PopUpPlayground/room-service/README.md

## Room Service

Code and hardware designs for Room Service, a game by Pop Up Playground.

- [YouTube Trailer](https://www.youtube.com/watch?v=t-5_sdyJ_b8)
- [Bookings](http://elsewhererooms.com/bookings/)

## Building

- Install `platformio`
- Type `make`

## Targets

- `native` - Used for local tests
- `teensy32` - Compiled game, no data files.
- `roomservice` - Compiled game, room service data files.

## Where are the data files?

They're the only thing *not* in the repository. They'd be super-mega spoilers for players
of the game!
