PopUpPlayground/room-service/(threads)

Thread 1 (2016-08-17):

Keypad requirements

pjf, 2016-08-17:
Keypad specs:

- 12 key (0-9, *, #)
- Must look cool (sample attached)
- Slight preference for 7-pin (x,y) models, versus 12-pin (individual key) models. We're unlikely to use multi-touch.

---

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

pjf, 2016-08-17:
This keypad [from jaycar](http://www.jaycar.com.au/12-key-numeric-keypad/p/SP0770) is $9, and looks good to me. :)

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

KangaBounce, 2016-08-21:
Jaycar keypad looks great!

pjf, 2016-08-22:
Note: We're going to star as reset, hash as execute (coding).

pjf, 2016-09-06:
I have the Jaycar keypad working ( #14, 213365fc08fd182e1176cfbd6afdc8c4fe0e40ae). The keys are rated to 1,000,000 keypresses. Assuming a typical game has a thousand key-presses, the pad should last a thousand games.

We may still go with another keypad for stylistic issues, but paying $9 every thousand games for keypad replacement is a really nice starting point. :)

pjf, 2016-09-30:
The $9 keypad is working great.

Closed 2016-09-30.

Thread 2 (2016-08-17):

Globes

pjf, 2016-08-17:
Globes are on of the things I'm most interested in, because they're going to take a lot of our power load, and will require the bulk of our control circuitry.

Requirements:

- Looks cool
- DC power (easier control circuitry)
- No more than 17V¹
- User-serviceable if not LEDs (which last forever)

¹ Assuming we're using a nifty power driver. 12V preferred.

pjf, 2016-08-18:
After evaluating control options ( #5 ), anything that uses 5V and up to 120mA looks way more attractive as we can control using I2C doohickies.

pjf, 2016-08-18:
Update: The drivers in #5 are low-side that allow up to 17V of voltage. We're golden. :)

pjf, 2016-08-22:
We have lights! We're using:

- ZD0150 Red LEDs
- ZD0170 Green LEDs
- SL???? Red Bezels
- SL2622 Green Bezels

We need:

- [ ] The number of LEDs we need total
    - Rooms
    - Doors
    - Baddies count
    - System load

pjf, 2016-09-05:
- [ZD0150](http://www.jaycar.com.au/red-5mm-led-12mcd-round-diffused/p/ZD0150)s take up to 30mA, provide 12mCd, 5mm, diffused $0.30ea. Not sure if 12mCd is a typo; probably not because diffuse.
- [ZD0152](http://www.jaycar.com.au/red-5mm-led-1200mcd-round-clear/p/ZD0152)s take up to 30mA, provide 1200mCd, 5mm, clear, $0.85ea
- [ZD0154](http://www.jaycar.com.au/red-5mm-led-3800mcd-round-clear/p/ZD0154)s, up to 50mA (more than we can drive on single-pins), 3800mCd, clear, $1.45ea
- [ZD0156](http://www.jaycar.com.au/red-5mm-led-9600mcd-round-clear/p/ZD0156) are magic. Up to 50mA, 9600mCd, clear, $3.45ea

I'm going to try and demonstrate ZD0152s since they're going to be much more visible in a range of lighting, but being a lens-type rather than diffuse-type pokéLeds mean they might not give us the old-school look we're after.

pjf, 2016-09-05:
10mm LEDs would also work:

- [ZD0200](http://www.jaycar.com.au/red-10mm-led-8mcd-round-diffused/p/ZD0200), $0.75ea, 8mCd diffuse
- [ZD0201](http://www.jaycar.com.au/red-10mm-led-5600mcd-round-clear/p/ZD0201), $1.45ea, 50mA, 5600mCd, $1.45ea, lensed

pjf, 2016-09-21:
Globes are ordered and in. We're using ZD150s, ZD0152s, and SL2622 and SL???? bezels.

Closed 2016-09-21.

Thread 5 (2016-08-17):

Drivers for lights

pjf, 2016-08-17:
We're likely to need a boatload of shift registers or other circuitry to control the scores of lights we'll be operating.

The [74HC164](http://www.jaycar.com.au/74hc164-8-bit-serial-in-out-shift-register-ic/p/ZC4857) serial-in, parallel-out shift registers are $1.75 each, and look like they can run off a supply voltage of anywhere from 2V to 7V, so they're probably good for our needs (anticipating a 3.3V microcontroller, but maybe a 5V one).

---

Status: Have a [TLC5947](https://www.adafruit.com/product/1429) on order from AdaFruit to test with.

pjf, 2016-08-17:
Other (probably better) options:

- [STP16CP05](http://www.st.com/content/ccc/resource/technical/document/datasheet/f2/92/00/f9/dd/4a/43/22/CD00126634.pdf/files/CD00126634.pdf/jcr:content/translations/en.CD0012663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) runs up to 16 lights at 100mA, as a shift register.
- [TLC59116](http://www.ti.com/lit/ds/symlink/tlc59116.pdf) runs up to 16 lights up to 120mA @ 17V as an I2C controller. 3.3 and 5V compatible, *and* supports PWM.

TLC59116 looks like it's winning hardware wise.

pjf, 2016-08-18:
OMG, the TLC59116 is a low-side driver that lets us push up to 17V through the load. Duck yes.

pjf, 2016-08-18:
https://www.adafruit.com/product/1429 lets us control up to 30mA with 24 lines out, based on the TLC5947 chip. It's an SPI using shift register with PWM support.

Most importantly, it has nice pitch. I like the TLC59116 more, but this is something we could reasonably solder. :)

pjf, 2016-08-18:
LittleBird has the [TLC5947](https://littlebirdelectronics.com.au/products/adafruit-24-channel-12-bit-pwm-led-driver-spi-interface-tlc5947) controllers from AdaFruit, so these are currently winning despite not being I2C.

pjf, 2016-08-21:
Have ordered a TLC5947 from LittleBird to test with.

pjf, 2016-08-21:
LittleBird don't have the TLC5947 in stock. I've asked how long a wait we're looking for; we may switch drivers if it's too long.

pjf, 2016-08-21:
TronixLabs has a TLC5947; on way! :)

pjf, 2016-08-28:
After diagnosing a poorly soldered joint on the controller I was using, I was able to get the TLC5947 to work beautifully as a driver. The programming is very straightforward using the library from AdaFruit:

```C++
void loop() {

  // Turn all the lights on to full
  for (int i=0; i <= 23; i++) {
    tlc.setPWM(i, 4095);
  }
  tlc.write(); // Sends cmd to board
  digitalWrite(pwr,HIGH); // Set diagnostic LED on teensy

  delay(1000);

// Turn all the lights off again.
  for (int i=0; i <= 23; i++) {
    tlc.setPWM(i, 0);
  }
  tlc.write();

  digitalWrite(pwr,LOW);
  delay(500);
}
```

Github support videos, but imagine this is doing this blinking thing:

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

Pulse-width modulation (PWM) also works a treat, so we can get different intensities which means we can try for special effects like flickering, or just the ability to manually control the light intensity.

@Sayraphim has given me the go-ahead to order more drivers if tests are successful, and since they are I'm doing that now and marking this as resolved. :) Expecting a little over a week to get them from LittleBird.

CC'ing in @KangaBounce to show we're making progress, even though I've been snowed under with book edits and talk-writing the last week. :)

KangaBounce, 2016-08-28:
Great work @pjf :)

Closed 2016-08-28.

Thread 6 (2016-08-17):

Program design

pjf, 2016-08-17:
### Once per cycle operations

- [x] An event queue, so we can trigger things when needed
- [ ] An input handler for the GM (serial terminal)
- [ ] Input handler for the players (keypad)

### Software Classes

- [ ] Actor. Mostly baddies.
    - Current path (see #4)
    - Objective?
    - Speed?
    - Current room.
    - Flags: Eg: "Waiting" flag (for elevator), "Unconscious", etc.
- [ ] Portals
    - Mostly doors, but also includes stairs and elevators
    - The edges of our map
    - Can be active (passable) or inactive (locked down)
    - Can have triggers (wait for elevator, decrease HP, etc)
    - Portals *must* have triggers, the default being `MoveActor`
    - Flags?
- [ ] Triggers / Edges
    - Executed by portals, maybe other events.
    - Needs to receive actor, triggering object (usually a portal)
    - Responsible for moving actor if allowed.
    - The most common trigger is `MoveActor`, which just lets them move.
    - Needs a light status, for displaying on map
- [ ] Map
    - Big giant adjacency graph
    - CPU cheap but memory hungry: N×N array of pointers to triggers (null is no adjacency)
        - Assuming 60 rooms and 32 bit pointers, 14.4k memory.
    - CPU hungry but memory cheap: Hash of structs: (destination, trigger)
        - Only requires 2 × number of edges on map.
        - Probably going with this, because microcontroller

### Maybe Classes

#### Rooms

We probably do need room objects, just so we can then attach labels to them, but they can probably be fairly simple. They may not need a list of actors inside (instead the actors point to the room they're in), nor may they need portals.

### Hardware Classes

- [ ] Keypad
- [ ] GM?
- [ ] I2C joy

### Example code paths

#### Regular movement

Thirsty Theo wants to visit the bar. His pathing algorithm calculates the best path, and sets a `Move` event in the event queue.

When the event triggers, the next vertex in Theo's path is removed from the queue and executed. This moves Theo, and schedules another event for his next movement.

Eventually Theo makes it to the bar.

#### Blocked movement

As above, but Theo encounters a locked door. Executing that trigger doesn't cause Theo to move, but instead dumps his movement queue, and re-calls the pathfinding algorithm. This sets a `Move` event in the event queue, and we restart from regular movement above.

#### Elevator

Carly the Cannibal wants to head to dinner, and paths down a the hallway to the liftwell. Once there, she triggers the `CallElevator` trigger by trying to move into the floor below. This event sets the "waiting" flag on Carly's object.

Each `MoveElevator` event, the elevator:
- Moves in the same direction it was before, unless it's at the top or bottom of its path, in which case it reverses direction.
- Checks the lobby for all actors that have the "waiting" flag, and moves them into the elevator.
- Checks everyone in the elevator, and if their next room is the lobby the elevator is on, moves them to that room, clears their waiting flag, and moves them into the lobby (also scheduling their next move event).

Gosh, elevators are complex!

pjf, 2016-08-22:
Notes:

- Players have 30 minutes
- Basic game can start without elevators, there are enough stairs
- GM selectable characters at start of game (pre-grouped)
- Difficulty determines how often codes can be used, and duration they last for.

pjf, 2016-08-22:
## Codes

- Limited number of uses (may be MAXINT)
- Door locking duration
- Which doors(s) they lock.
- *May* have mutexes / common resources. (Eg: only one zone can "hold the conch")
- May have repeating parts, but they count as separate codes. (Eg: `*RoomNumber12345#` to lock a room.)

pjf, 2016-09-21:
Rooms don't need to contain a list of actors, as the list of actors is way smaller than the list of rooms. This means we can simply rebuild a list of "occupied rooms" each movement.

pjf, 2016-09-30:
We've got a running game, so I'm closing out these old tickets. :)

Closed 2016-09-30.

Thread 8 (2016-08-19):

Test investigate interrupt-driven signals from keypad.

pjf, 2016-08-19:
The players will be pressing buttons on the keypad, and we don't want to lose them. We should investigate if the Teensy can do interrupt-driven signals. The code itself just has to take the keypress and put it in a buffer, maybe raising a flag for the main loop when it notices the code has been finished.

pjf, 2016-09-30:
We're not using interrupts, but the keypad is hella responsive, this works.

Closed 2016-09-30.

Thread 12 (2016-08-22):

Player Interface

pjf, 2016-08-22:
- Map with lights (for room and doors)
- Keypad
- 16x2 display
- System load (how many doors locked, etc)
- Current guests
- Bell we can ring.
- Buzzer.

pjf, 2016-09-30:
We have a running game. Closing this for now, and will create a new ticket when we want more bells and whistles.

Closed 2016-09-30.

Thread 13 (2016-08-28):

Controller board

pjf, 2016-08-28:
Right now I'm using a Teensy-LC, which is a glorious work of art. However it only has 8k of RAM, which we may bump up against with a project of this size.

If that happens, we may wish to shift to a [Teensy 3.2](https://littlebirdelectronics.com.au/products/teensy-3-2) ([spec](https://www.pjrc.com/teensy/teensy31.html)), which has an [elephantile 64k of RAM](https://s-media-cache-ak0.pinimg.com/564x/da/ec/4c/daec4c0186691666688529eeffb57b02.jpg). Australian suppliers have lots of them in stock, so I suggest we put in an order if it becomes clear we need one.

pjf, 2016-09-30:
Teensy 3.2 is best. We're using it. <3

Closed 2016-09-30.

Thread 14 (2016-09-05):

Today's testing schedule

pjf, 2016-09-05:
- [ ] 16x2 display
- [ ] Chained drivers
- [ ] 3x4 numpad

Purchases needed:

- [x] Pin-to-pin jumpers
- [x] Socket-to-pin jumpers
- [x] Keypad
- [x] ZD0152, ZD0200, ZD0201 LEDs¹
- [x] 3280Ω resistors so we can can drive 30mA lights.

---

¹ I'm not fully convinced by the low-cost ones we have. See #2 .

pjf, 2016-09-06:
Everything tested! Yay hardware!

Closed 2016-09-06.

Thread 15 (2016-09-10):

System Load and code attributes

pjf, 2016-09-10:
We've got a concept of "system load", whereby players can only have a limited number of locks in play at once. We'll need to flesh this out properly for coding.

## Basic System

I'm imagining the following:

- The security system available to the player has a maximum number of "load points" which is configurable at game start. Let's assume five.
- Each "lock" costs a configurable number of load points, which are locked until that code expires.
- A display or indicator showing system load, so the players know exactly how close they are to things going bad.

## Overload (open question)

In the case where not enugh load points are available, but the player enters a code, do we...

- Dump a *random* lock, and try again.
- Dump the *oldest* lock, and try again.
- Refuse the code.

In the case of dumping a random lock, do we weight them all equally, or do we favour dumping or more expensive locks instead (a weighted approach)?

Should we ask the players to confirm if we'd have to dump locks if they want to enter a new code?

If we refuse codes, I'd want to give the players a way to manually drop existing locks, but that potentially adds complexity if it's anything other than a "unlock all" button (which I think we should give them anyway).

## Interesting mechanics

An interesting mechanic of having configurable costs for security codes is we can make the following:

- Balanced codes: Costing roughly proportional to their value to the players. Single-doors might cost one load point, a room might cost two, an area lock-down might cost three or four.
- Free codes: These codes wouldn't cost *any* load. We'd probably make them short lived, but they're good for use in an emergency.
- Expensive codes: These codes code a lot *more* load than we'd otherwise expect. They might have other advantages (a much longer lock-time, or reusability), or the players could start with them as a way to help them rapidly encounter locking mechanics.

pjf, 2016-09-30:
We're not doing system load for now. Instead we may have door lock degradation.

Closed 2016-09-30.

Thread 17 (2016-09-11):

Event Queue

pjf, 2016-09-11:
The heart of our program is the event loop. I'm tracking that here.

Currently I was thinking of making events be functions that return void, but I think I'm going to make them return strings, which then get displayed on the game-runner's console. This makes debugging much easier.

pjf, 2016-09-11:
Duck yes! Working as of 8ac9818fc6803e8831a1d5fa83ca9106831cff36 .

Was so excited I didn't include the ticket number in the commit. :)

Closed 2016-09-11.

Thread 28 (2016-09-30):

Toughening up the electronics

pjf, 2016-09-30:
Mostly for @KangaBounce , but CC'ing in @Sayraphim just in case:

---

Right now the electronics we've got are a bit fragile. There are three things I'd like to do in order to toughen them up:

**Replacing serial connections between the drivers with a dedicated buses**

The only cable between our TLC5947 drivers that *needs* to be connected in serial is the data-in/data-out cable. The rest (+5V, GND, CLK, LAT, OE) are all wired through, but they build up a significant resistance along the way (3 ohms!) which is causing all sorts of glitching. I'd like for us to have dedicated [bus bars](http://www.jaycar.com.au/machined-brass-busbar-8-way/p/SZ2003) for *at least* +5V and GND. I'd also *love* to add buses for CLK, LAT, OE, and +3.3V (from the controller) as they've all got multiple connections over the place, and we're not exactly restrained by small spaces.

In this scenario we'd have a star configuration for the wiring (everything but data going back to their appropriate bus) rather than a serial configuration, so if something goes wrong it will be very obvious what that something is. Wires would just go directly from the bus to the input (or output) on the boards. This should also drop our resistances *way* down, which is particularly important for power. Data-in/data-out still needs to go serially between the boards.

Ideally we'd solder the connections in at the controllers, but we can leave them as plugs for a first pass, and possibly permanently if they're stable enough.

I'd be directly screwing the power supply to the +5V and GND bus rails, so we're not worried about joints in the connector.

**Adding a power capacitor**

I'm not at all convinced the power in the building is at all clean, given that we switched on the main lights and it resulted in pretty artefacts on the majordomo board. Putting a [power conditioning capacitor](http://www.jaycar.com.au/10000uf-40vdc-electrolytic-rp-capacitor/p/RU6720) across the +5V and GND buses will resist any oddities that we might get passed through to our hardware.

We need to make sure we don't install the cap backwards. :)

pjf, 2016-10-08:
Turns out the buses make everything *waaaaay* more robust. Switching the main lights on and off have no effect on the board, so we're clean enough without a power cap for now. Resolving with great things to @KangaBounce for doing such super-amazing work! <3

KangaBounce, 2016-10-08:
I wish it was neater @pjf haha

Closed 2016-10-08.

Thread 30 (2016-10-09):

Guest goals and alternate gameplay

pjf, 2016-10-09:
Right now our players have more motivation to control the guests near the end of the game (when they're hungry) than near the start of the game (when they're not). However one alternate gameplay mode which has been proposed is to have the players door start locked, and the guests to complete a number of objectives to unlock it, after which they're at risk of losing.

This would come with a different introduction. The service kitchen has been placed into lockdown, but this can be overriden from locations around the hotel: the plant room, the office, a terminal in the library, etc.

The players' door would have a number of lights (eg: 5) above it indicating the level of lock-down. We have a heartbeat that checks to see if guests are in one of the goal locations, and if so the number of lights goes down by one, and that location is crossed off the objectives list.

This provides a constant pressure on the players to keep the guests out of certain areas. This becomes harder as more guests are moving, and combined with door decay (#29) keeping a specific room locked down becomes increasingly challenging.

From a coding standpoint, much of this is easy to add. We already have heartbeats with the plant room lockout. Guests already have goal lists they execute, and which change with hunger. We're probably just adding a boolean to each room (is it a current goal) which gets cleared when it's completed. We can even have events which *add* rooms as goals, so players have to concentrate on more areas over time.

The lights above the door simply require a driver of some sort and some code to display the number of locks remaining.

It would be nice if current goals on the map were indicated visually somehow, perhaps by having an LED `breathing` by adjusting its PWM values over time. We'd need to test this with the current event loop to see if it looks good or if there's noticeable lag during heavy CPU usage (eg: pathfinding).
