PopUpPlayground/room-service/kicad/room-service.kicad_pcb

## KiCad design Electronics/ProtoRev0/BrailleBoy/BrailleBoy.sch

Schematic: BrailleBoy.sch

Parts:
C1, C2, C3, C4, C5, C8, C10: 0.1uF; C_0805
C9: 10uF; C_0805
D1: IND0; LED_0805
D2: IND1; LED_0805
D3: IND2; LED_0805
D4: IND3; LED_0805
R1, R2, R3, R4, R8: 10K; R_0805
R5, R6, R7, R9, R10, R11, R12: 51R; R_0805
SW1: B0; SW_SPST_B3S-1000
SW2: B1; SW_SPST_B3S-1000
SW3: B2; SW_SPST_B3S-1000
SW4: B3; SW_SPST_B3S-1000
SW5: RESET; SW_SPST_B3S-1000
TP1: Boot Option; SW_SPST_B3S-1000
U1: MCP23S17; SOIC-16_3.9x9.9mm_Pitch1.27mm
U3: ESP32-WROOM

Notes on the sheet:
SOLENOID FET MATRIX AND MCP23X17 I/O EXPANDER WITH SOLENOID FET MATRIX ATTACHED HIGH SIDE FETS - GPA BANK; LOW SIDE FETS - GPB BANK
POWER MANAGEMENT AND SERIAL COMMUNICATION
INPUTS - BUTTONS
I2S MICROPHONE - SINGLE CHANNEL
