PopUpPlayground/room-service/kicad/room-service.kicad_pcb

## KiCad design Electronics/ProtoRev0/BrailleBoy/FETsDrivers.sch

Schematic: FETsDrivers.sch

Parts:
C20, C22, C24: 0.1uF; C_0805
C21, C23, C25: 10uF; C_0805
Q3: H0
Q4: H1
Q5: H2
Q6: H3
Q7: H4
Q8: H5
Q9: L0
Q10: L1
Q11: L2
Q12: L3
Q13: L4
Q14: L5
R23, R24, R25, R26, R27, R28, R29, R30, R31, R32, R33, R34: 10K; R_0805
U7, U8, U9, U10, U11, U12, U13, U14, U15, U16, U17, U18: PMD3001D; TSOP-6_1.65x3.05mm_Pitch0.95mm
U19: TC1240(A); SOT-23-6

Notes on the sheet:
LOW SIDE FETS
HIGH SIDE FETS
MOSFET DRIVERS
CHARGE PUMP FOR MOSFET DRIVERS
