PopUpPlayground/room-service/kicad/room-service.kicad_pcb

## KiCad design Electronics/ProtoRev0/BrailleBoy/SolenoidFetMatrix.sch

Schematic: SolenoidFetMatrix.sch

Parts:
C16: 22uF; C_0805
C17: 10uF; C_0805
C18, C19: 0.1uF; C_0805
L1, L2, L3, L4, L5, L6, L7, L8, L9, L10, L11, L12, L13, L14, L15, L16, L17, L18, L19, L20, L21, L22, L23, L24, L25, L26, L27, L28, L29, L30, L31, L32, L33, L34, L35, L36: L

Notes on the sheet:
CHARACTER
CHARACTER DISPLAY DOT_COM = [TOP/MID/BOT][LEFT/RIGHT] CHAR_COM = [CHAR[0:5]]
DECOUPLING
