PopUpPlayground/room-service/kicad/room-service.kicad_pcb

## KiCad design Electronics/ProtoRev0/BrailleBoy/Uart.sch

Schematic: Uart.sch

Parts:
C15: 0.1uF; C_0805
D5: RX; LED_0805
D6: TX; LED_0805
Q1, Q2: SS8050-G; SOT-23
R18, R21, R22: 270R; R_0805
R19, R20: 10K; R_0805
U6: FT232RL; SSOP-28_5.3x10.2mm_P0.65mm
