PopUpPlayground/room-service/kicad/room-service.kicad_pcb

## KiCad design Electronics/ProtoRev0/BrailleBoy/powermgmt.sch

Schematic: powermgmt.sch

Parts:
C11: 10uF; C_0805
C12, C14: 0.1uF; C_0805
C13: 1uF; C_0805
J1: USB_B_Micro; LED_0805
J2: Battery; JST_PH_B2B-PH-SM4-TB_02x2.00mm_Straight
R13, R14, R15, R16: 10K; R_0805
R17: 2K; R_0805
U4: AP2115-SOIC; SOIC-8_3.9x4.9mm_Pitch1.27mm
U5: MCP73832-2-OT; SOT-23-5
