PopUpPlayground/room-service/src/Portal.cpp

#include "Portal.h"
#include "Actor.h"
#include "Room.h"

// Moes the actor to the given room, without checking for locks or anything
void Portal::moveActor(print_f print, Actor *actor, const Room *dst) {
    // print("...moving actor: ");
    // print(actor->name);
    // print(" to ");
    // print(dst->name);
    // print("...");

    actor->room = dst->number;

    // print("DONE\n");
}
