PopUpPlayground/room-service/(commit log)

2016-09-05 Added kicad schematics
    [room-service.kicad_pcb, room-service.sch]
2016-09-06 Chained TLCs working!
2016-09-06 Add TLC5947 and keypad pins to schematic.
    [room-service.sch]
2016-09-11 Proof-of-concept testing framework added.
2016-09-11 Using platformio's own testing framework now.
2016-09-11 Updated Makefile for new testing and build frameworks
2016-09-11 Replaced std::pair<> with std::make_pair()
    Because it's shorter.
    [EventQueue.cpp]
2016-09-24 LEAK FREE PATHFINDER AWW YIS!!!
    Also lots of debug code, deal with it. :)
    [Map.h, Room.h]
2016-09-24 Update target to Teensy 3.1/3.2
    The Teensy-LC doesn't have the memory for our programme now.
2016-09-24 Map.cpp: Make sure our shortestPath is always initialised.
    [Map.cpp]
2016-09-25 Everything uses print_f pointers now.
    I wish I could use streams, but apparently arduino C++ doesn't support
    that.
    [Event.h, EventQueue.cpp, GoalEvent.cpp, GoalEvent.h, MsgEvent.cpp, MsgEvent.h]
2016-09-25 Fixed weird zeros in pathfinding! SHIA LIVES!!!!
    [Actor.cpp, Actor.h, Map.cpp, Map.h, MoveEvent.cpp]
2016-09-26 Doors and rooms now have LED numbers.
2016-09-26 kicad: Updated pin-outs
    [room-service.sch]
2016-09-26 Track if game state has been shown to player
2016-09-27 Hardware fixes: Init TLC pins, update TLC qty, fix LED testing reset.
    [HwConsole.h, main.ino]
2016-09-27 Map room creation tools accept LED numbers.
2016-09-28 Locking non-existent doors no longer crashes game
    [Map.cpp, Map.h, types.h]
2016-09-28 Lots of error checking on maps.
    [Goals.cpp, Goals.h, Map.cpp, Map.h]
2016-09-28 Added hunger, but not hunger timer.
2016-09-28 More defensive programming.
    We can't have the game error out part way through.
    [Goals.cpp, HwConsole.cpp, HwConsole.h, main.ino]
2016-09-28 Memory; Pathfinding will now skip over dead ends early.
    [Map.cpp, Map.h]
2016-09-28 Pathfind/Memory: Memory blowout fixed
    We can skip any room we know is on our future pathfinding routes, not
    just our current breadcrumbs.
    [Actor.cpp, Map.cpp, Map.h, main.ino]
2016-09-29 Clear LED before game start.
